NathanVandeHel/Nixie-clock/(list of files, drawings)

Other design files:
PCB/NIXIE CLOCK V3/PCB_2020-06-28_18-55-56.json
