NathanVandeHel/Nixie-clock/(commit log)

2022-10-11 PCB files added
    [PCB_2020-06-28_18-55-56.json]
2022-10-15 fixing a display bug when setting the time
    [nixie.ino]
2022-10-17 adding power consumption ratings
2022-10-20 fix a eco mode bug
    [nixie.ino]
